moonbeeper/moonpad/macropad/symbols/3dobjs/USB-C-SMD_G-SWITCH_GT-USB-7010ASV.step

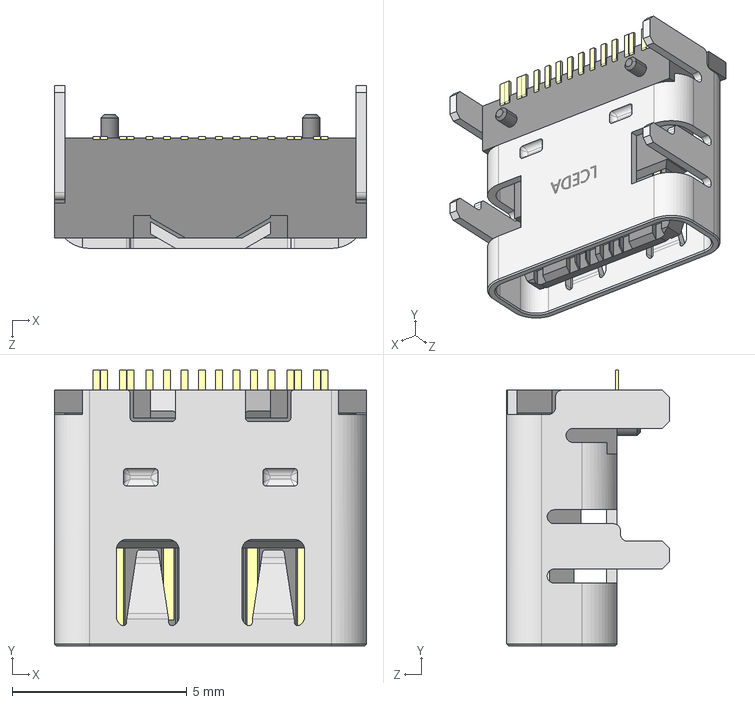
[picture p1: CAD file, 2026-05-30]
macropad/symbols/3dobjs/USB-C-SMD_G-SWITCH_GT-USB-7010ASV.step
8.94 x 7.90 x 4.66 mm
