moonbeeper/moonpad/macropad/symbols/3dobjs/KEY-SMD_2P-L3.0-W2.5-H1.6-LS4.0.step

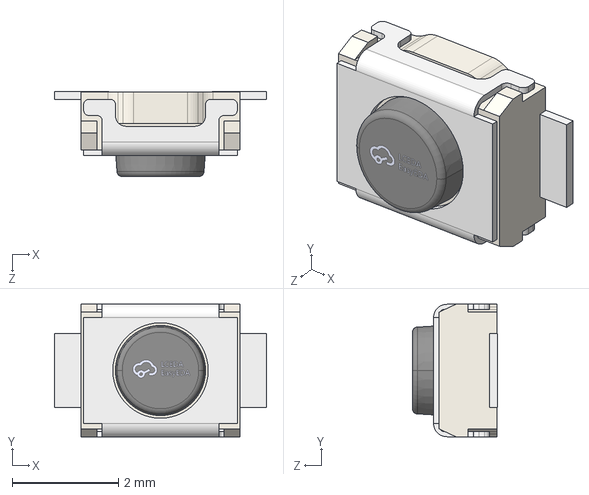
[picture p2: CAD file, 2026-05-30]
macropad/symbols/3dobjs/KEY-SMD_2P-L3.0-W2.5-H1.6-LS4.0.step
4.00 x 2.50 x 1.61 mm
