moonbeeper/moonpad/macropad/symbols/3dobjs/SW-SMD_MK-12C02-G020.step

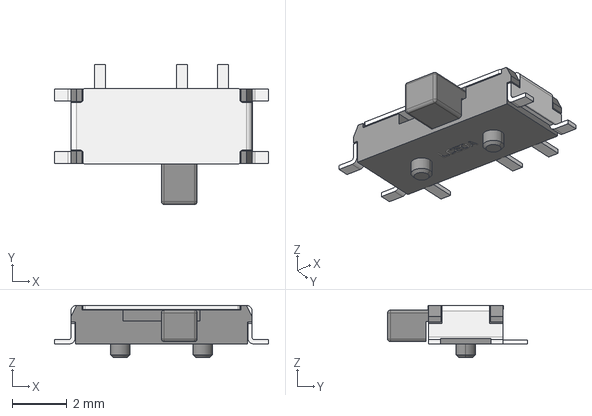
[picture p3: CAD file, 2026-05-30]
macropad/symbols/3dobjs/SW-SMD_MK-12C02-G020.step
7.80 x 5.10 x 1.90 mm
