moonbeeper/moonpad/macropad/symbols/3dobjs/SW-TH_EC11XXXXXXXX-L11.7-W12.0-H24.5-P2.5-LS14.5.step

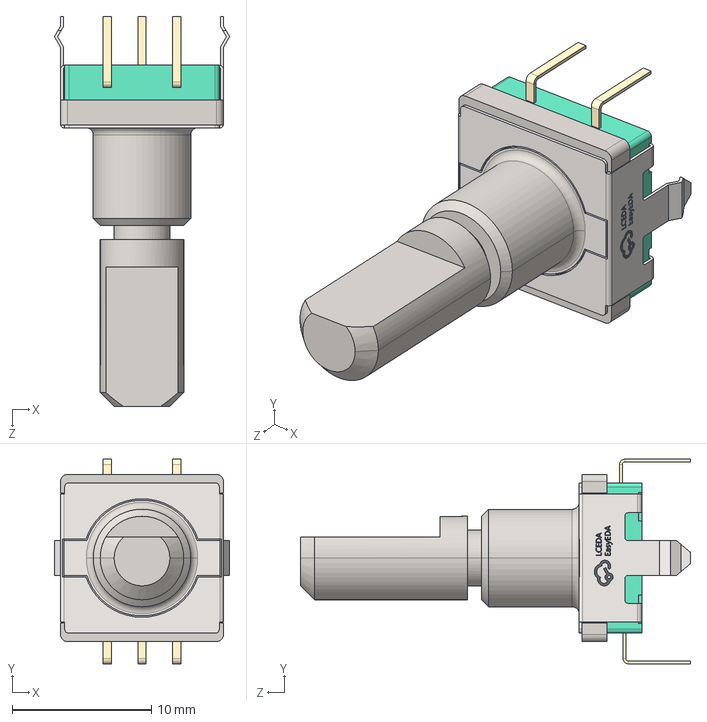
[picture p4: CAD file, 2026-05-30]
macropad/symbols/3dobjs/SW-TH_EC11XXXXXXXX-L11.7-W12.0-H24.5-P2.5-LS14.5.step
12.6 x 14.7 x 28.0 mm
