moonbeeper/moonpad/macropad/symbols/3dobjs/KEY-SMD_L4.6-W3.4-H3.4.step

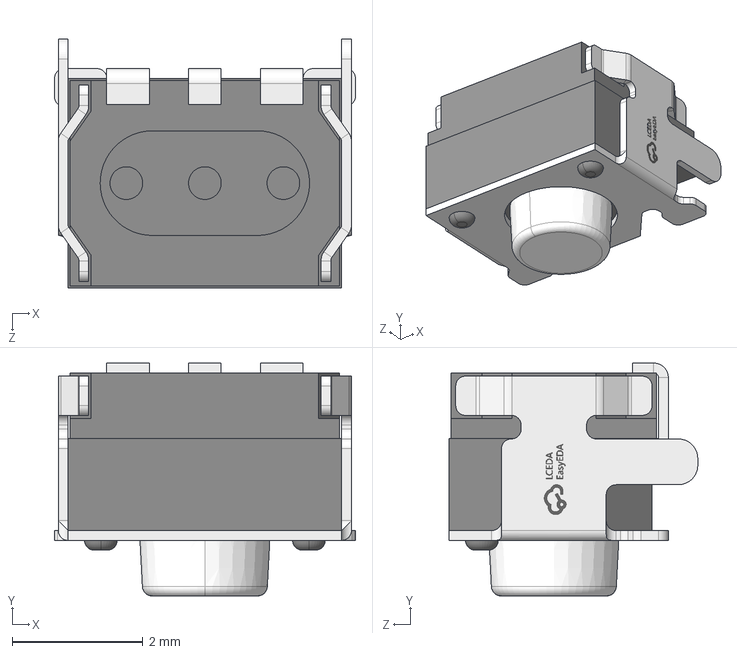
[picture p5: CAD file, 2026-05-30]
macropad/symbols/3dobjs/KEY-SMD_L4.6-W3.4-H3.4.step
4.60 x 3.56 x 3.80 mm
