moonbeeper/moonpad/macropad/macropad.kicad_pcb

## KiCad design macropad/macropad.kicad_pcb (2026-05-30)

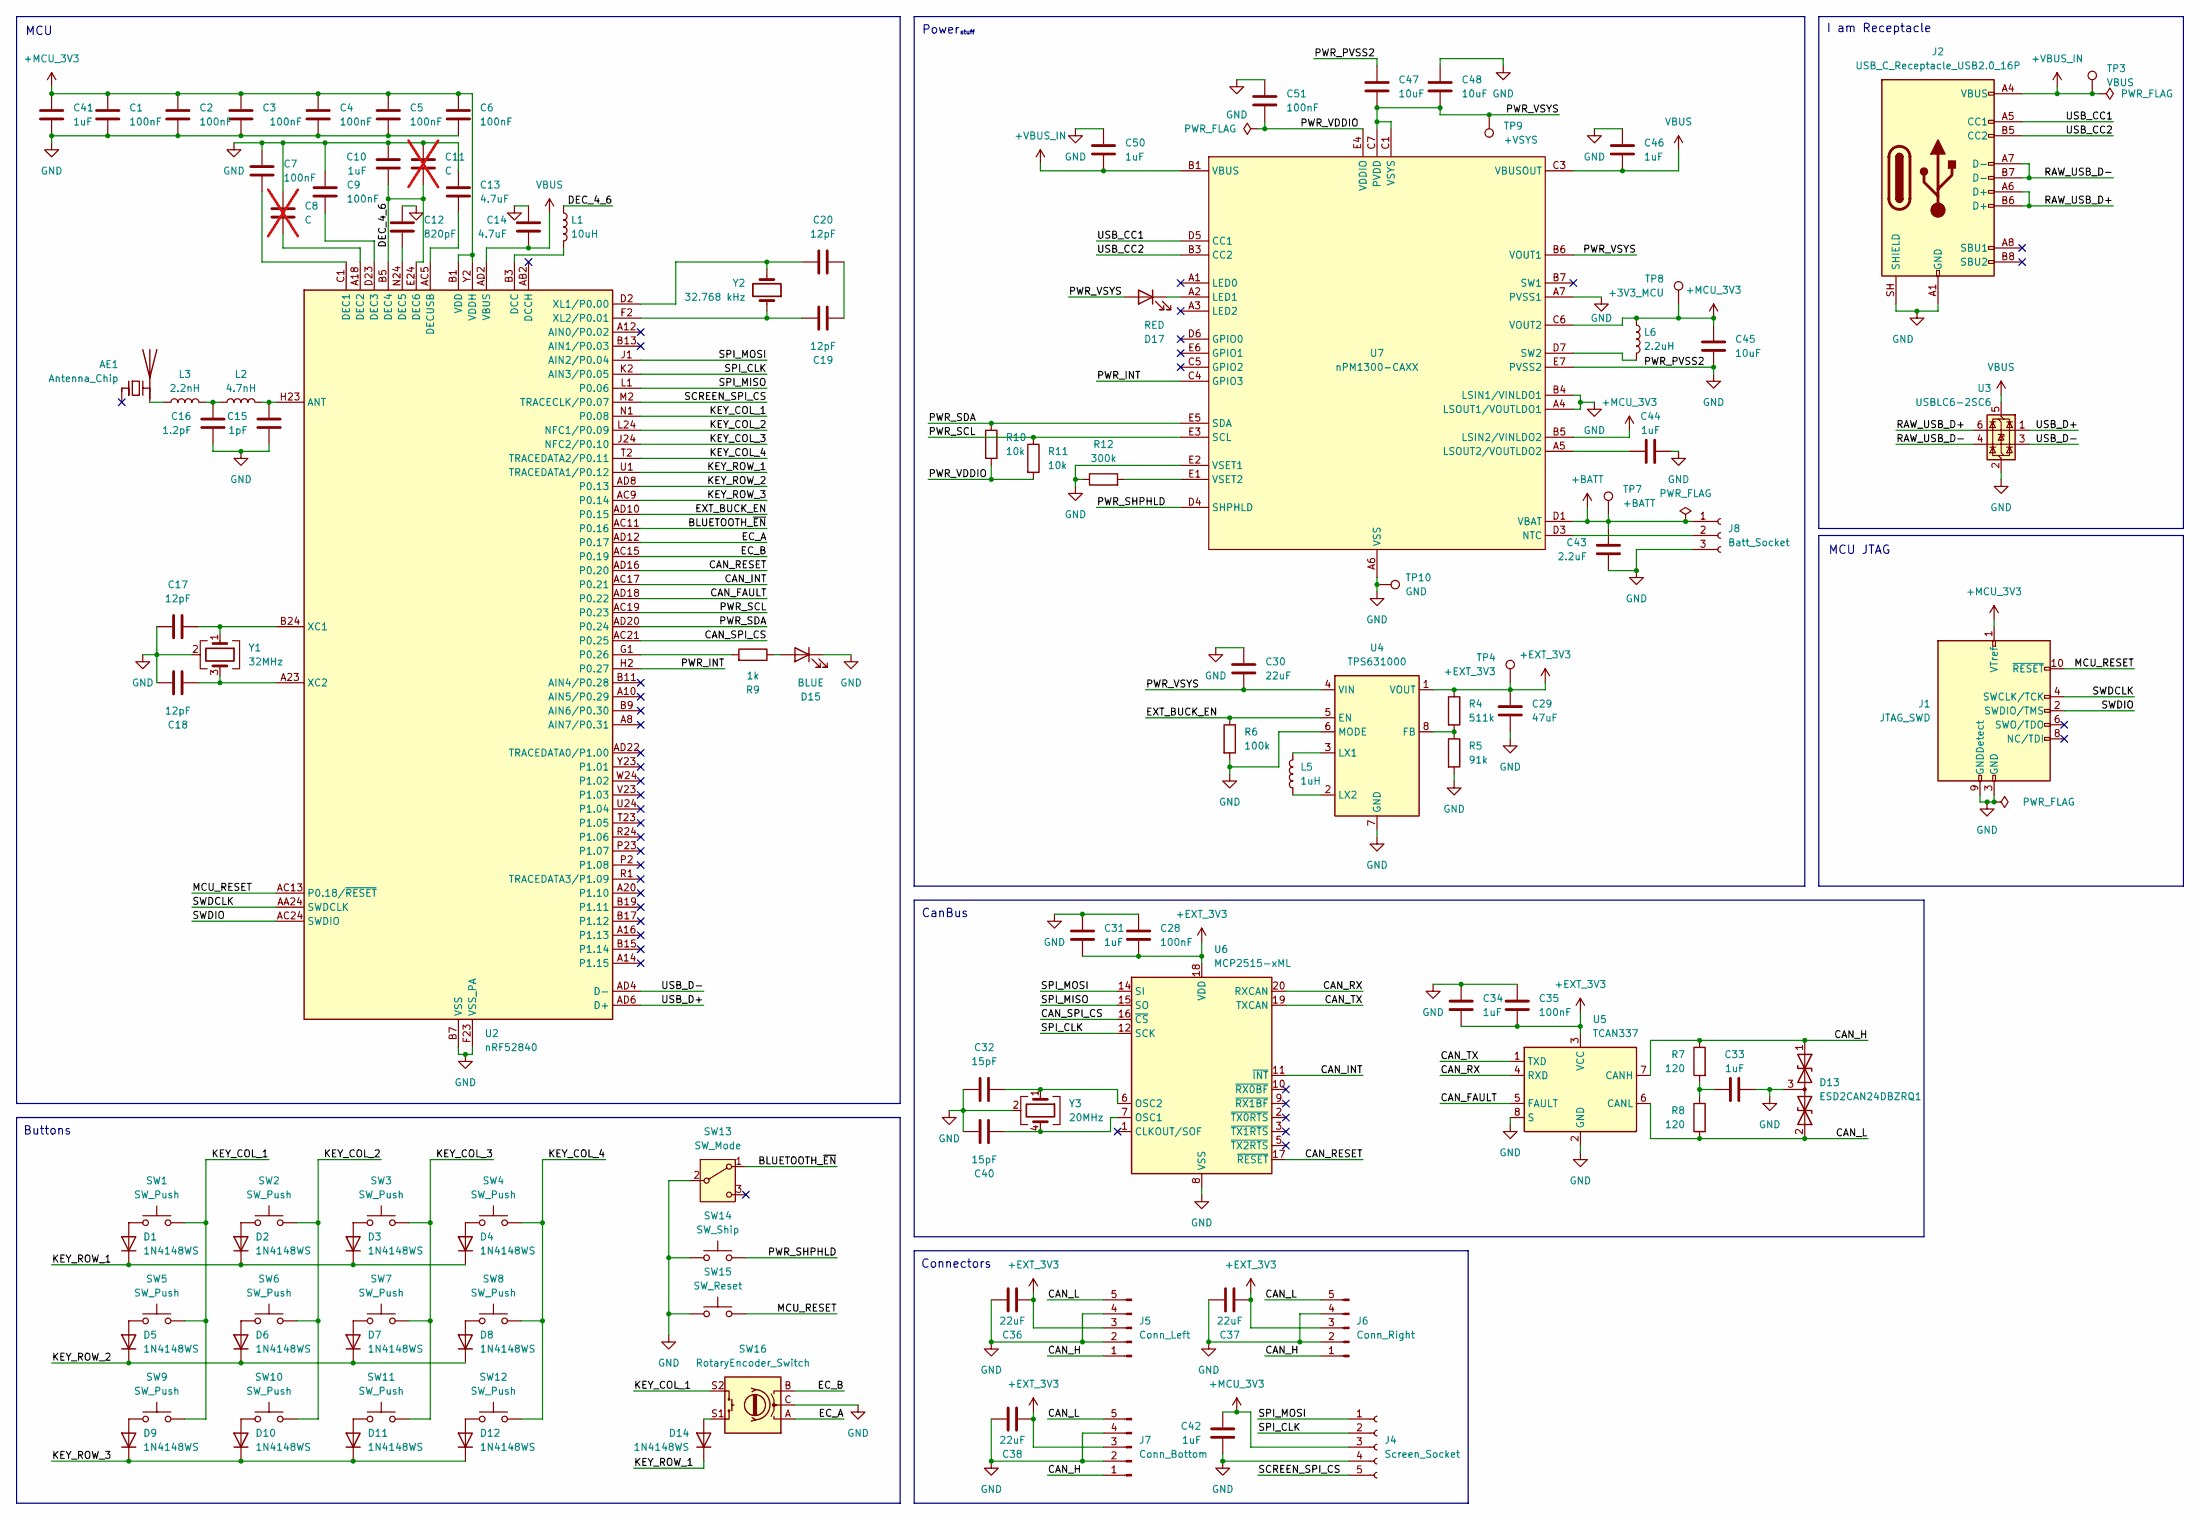
[picture p6: schematic macropad.kicad_sch, MoonPad Macropad]

Parts:
AE1: Antenna_Chip; D_1206_3216Metric; MPN ANT3216LL00R2400A; LCSC C293767
C1, C2, C3, C4, C5, C6, C7, C9, C28, C35, C51: 100nF; C_0603_1608Metric; MPN CC0603KRX7R9BB104; LCSC C14663
C8, C11: C; not fitted
C10, C31, C33, C34, C41, C42, C44, C46, C50: 1uF; C_0603_1608Metric; MPN CL10B105KB8NQNC; LCSC C5199872
C12: 820pF; C_0603_1608Metric; MPN CC0603JRNPO9BN821; LCSC C107057
C13, C14: 4.7uF; C_0603_1608Metric; MPN GRM188Z71C475KE21D; LCSC C389010
C15: 1pF; C_0402_1005Metric; MPN CC0402BRNPO9BN1R0; LCSC C309455
C16: 1.2pF; C_0402_1005Metric; MPN CC0402BRNPO9BN1R2; LCSC C327292
C17, C18, C19, C20: 12pF; C_0603_1608Metric; MPN CC0603GRNPO9BN120; LCSC C519450
C29: 47uF; C_0805_2012Metric; MPN GRM21BR61A476ME15L; LCSC C124129
C30, C36, C37, C38: 22uF; C_0805_2012Metric; MPN CL21A226MPQNNNE; LCSC C29277
C32, C40: 15pF; C_0603_1608Metric; MPN CC0603GRNPO9BN150; LCSC C519451
C43: 2.2uF; C_0603_1608Metric; MPN CL10A225KB8NNNC; LCSC C913904
C45, C47, C48: 10uF; C_0603_1608Metric; MPN GRM188R61E106KA73D; LCSC C344022
D1, D2, D3, D4, D5, D6, D7, D8, D9, D10, D11, D12, D14: 1N4148WS; D_SOD-323; MPN 1N4148WS; LCSC C917117
D13: ESD2CAN24DBZRQ1; SOT-23-3; MPN ESD2CAN24DBZRQ1
D15: BLUE; LED_0603_1608Metric; MPN GL0603UB01; LCSC C51933294
D17: RED; LED_0603_1608Metric; MPN GL0603UR01; LCSC C51933292
J1: JTAG_SWD; PinHeader_2x05_P1.27mm_Vertical
J2: USB_C_Receptacle_USB2.0_16P; USB_C_Receptacle_G-Switch_GT-USB-7010ASV; MPN GT-USB-7010ASV; LCSC C2988369
J4: Screen_Socket; PinHeader_1x05_P2.00mm_Vertical
J5: Conn_Left; PinHeader_1x05_P2.00mm_Vertical
J6: Conn_Right; PinHeader_1x05_P2.00mm_Vertical
J7: Conn_Bottom; PinHeader_1x05_P2.00mm_Vertical
J8: Batt_Socket; PinHeader_1x05_P2.00mm_Vertical
L1: 10uH; L_0603_1608Metric; MPN MLZ1608N100LT000; LCSC C194437
L2: 4.7nH; L_0402_1005Metric; MPN LQG15HS4N7S02D; LCSC C86065
L3: 2.2nH; L_0402_1005Metric; MPN LQG15HS2N2S02D; LCSC C86061
L5: 1uH; L_1008_2520Metric; MPN DFE252012P-1R0M=P2; LCSC C882955
L6: 2.2uH; L_0805_2012Metric; MPN DFE201210U-2R2M=P2; LCSC C2049745
R4: 511k; R_0603_1608Metric; MPN FRC0603F5113TS; LCSC C2930114
R5: 91k; R_0603_1608Metric; MPN FRC0603F9102TS; LCSC C2907077
R6: 100k; R_0603_1608Metric; MPN FRC0603F1003TS; LCSC C2906980
R7, R8: 120; R_0603_1608Metric; MPN FRC0603F1200TS; LCSC C2906988
R9: 1k; R_0603_1608Metric; MPN FRC0603F1001TS; LCSC C2907002
R10, R11: 10k; R_0603_1608Metric; MPN FRC0603J103 TS; LCSC C2930027
R12: 300k; R_0603_1608Metric; MPN FRC0603F3003TS; LCSC C2930091
SW1, SW2, SW3, SW4, SW5, SW6, SW7, SW8, SW9, SW10, SW11, SW12: SW_Push; SW_Hotswap_Kailh_Choc_V1V2_1.00u
SW13: SW_Mode; SW-SMD_MK-12C02-G020; MPN MK-12C02-G020; LCSC C963206
SW14: SW_Ship; KEY-SMD_SKRTLAE010; MPN SKRTLAE010; LCSC C110293
SW15: SW_Reset; KEY-SMD_B3U-1000PM; MPN B3U-1000P; LCSC C231329
SW16: RotaryEncoder_Switch; RotaryEncoder_Alps_EC11E-Switch_Vertical_H20mm; MPN EC11E09244BS; LCSC C470742
TP3: VBUS; TestPoint_Pad_D1.5mm
TP4: +EXT_3V3; TestPoint_Pad_D1.5mm
TP7: +BATT; TestPoint_Pad_D1.5mm
TP8: +3V3_MCU; TestPoint_Pad_D1.5mm
TP9: +VSYS; TestPoint_Pad_D1.5mm
TP10: GND; TestPoint_Pad_D1.5mm
U2: nRF52840; Nordic_AQFN-73-1EP_7x7mm_P0.5mm; MPN NRF52840-QIAA-F-R7
U3: USBLC6-2SC6; SOT-23-6; MPN USBLC6-2SC6; LCSC C2827654
U4: TPS631000; SOT-583-8; MPN TPS631000DRLR; LCSC C5219190
U5: TCAN337; SOIC-8_3.9x4.9mm_P1.27mm; MPN TCAN337DR; LCSC C2860648
U6: MCP2515-xML; QFN-20-1EP_4x4mm_P0.5mm_EP2.7x2.7mm; MPN MCP2515T-I/ML; LCSC C96140
U7: nPM1300-CAXX; BGA-35_7x5_3.077x2.3775mm; MPN NPM1300-CAAA-R
Y1: 32MHz; Crystal_SMD_2016-4Pin_2.0x1.6mm; MPN TX201632M4BBCE2T; LCSC C5339095
Y2: 32.768 kHz; Crystal_SMD_2012-2Pin_2.0x1.2mm; MPN SC-20S,32.768kHz,20PPM,9pF; LCSC C97603
Y3: 20MHz; Crystal_SMD_3225-4Pin_3.2x2.5mm; MPN 2.1.3.1600011; LCSC C42420972

Connections:
+BATT: C43.1, J8.1, TP7.1 (1_1), U7.D1 (VBAT), U7.D2 (VBAT)
+EXT_3V3: C28.2, C29.1, C31.2, C34.2, C35.2, C36.1, C37.1, C38.1, J5.3, J6.3, J7.3, R4.1, TP4.1 (1_1), U4.1 (VOUT), U5.3 (VCC), U6.18 (VDD)
+MCU_3V3: C1.1, C2.1, C3.1, C4.1, C5.1, C6.1, C41.1, C42.1, C45.1, J1.1 (VTref), J4.3, L6.1, TP8.1 (1_1), U2.A22 (VDD), U2.AD14 (VDD), U2.AD23 (VDD), U2.B1 (VDD), U2.W1 (VDD), U2.Y2 (VDDH), U7.B5 (LSIN2/VINLDO2), U7.C6 (VOUT2)
+VBUS_IN: C50.2, J2.A4 (VBUS), J2.A9 (VBUS), J2.B4 (VBUS), J2.B9 (VBUS), TP3.1 (1_1), U7.B1 (VBUS), U7.B2 (VBUS)
/BLUETOOTH_~EN: SW13.1 (A), U2.AC11 (P0.16)
/CAN_FAULT: U2.AD18 (P0.22), U5.5 (FAULT)
/CAN_H: D13.1 (A1), J5.1, J6.1, J7.1, R7.1, U5.7 (CANH)
/CAN_INT: U2.AC17 (P0.21), U6.11 (~INT)
/CAN_L: D13.2 (A2), J5.5, J6.5, J7.5, R8.2, U5.6 (CANL)
/CAN_RESET: U2.AD16 (P0.20), U6.17 (~RESET)
/CAN_RX: U5.4 (RXD), U6.20 (RXCAN)
/CAN_SPI_CS: U2.AC21 (P0.25), U6.16 (~CS)
/CAN_TX: U5.1 (TXD), U6.19 (TXCAN)
/DEC_4_6: C10.2, C11.2, L1.1, U2.B5 (DEC4), U2.E24 (DEC6)
/EC_A: SW16.A, U2.AD12 (P0.17)
/EC_B: SW16.B, U2.AC15 (P0.19)
/EXT_BUCK_EN: R6.1, U2.AD10 (P0.15), U4.5 (EN)
/KEY_COL_1: SW1.2, SW5.2, SW9.2, SW16.S2, U2.N1 (P0.08)
/KEY_COL_2: SW2.2, SW6.2, SW10.2, U2.L24 (NFC1/P0.09)
/KEY_COL_3: SW3.2, SW7.2, SW11.2, U2.J24 (NFC2/P0.10)
/KEY_COL_4: SW4.2, SW8.2, SW12.2, U2.T2 (TRACEDATA2/P0.11)
/KEY_ROW_1: D1.1 (K), D2.1 (K), D3.1 (K), D4.1 (K), D14.1 (K), U2.U1 (TRACEDATA1/P0.12)
/KEY_ROW_2: D5.1 (K), D6.1 (K), D7.1 (K), D8.1 (K), U2.AD8 (P0.13)
/KEY_ROW_3: D9.1 (K), D10.1 (K), D11.1 (K), D12.1 (K), U2.AC9 (P0.14)
/MCU_RESET: J1.10 (~RESET), SW15.2, U2.AC13 (P0.18/~RESET)
/PWR_INT: U2.H2 (P0.27), U7.C4 (GPIO3)
/PWR_SCL: R11.1, U2.AC19 (P0.23), U7.E3 (SCL)
/PWR_SDA: R10.1, U2.AD20 (P0.24), U7.E5 (SDA)
/PWR_SHPHLD: SW14.2, U7.D4 (SHPHLD)
/PWR_VDDIO: C51.2, R10.2, R11.2, U7.E4 (VDDIO)
/PWR_VSYS: C30.2, C47.2, C48.2, D17.2 (A), TP9.1 (1_1), U4.4 (VIN), U7.B6 (VOUT1), U7.C1 (VSYS), U7.C2 (VSYS), U7.C7 (PVDD)
/RAW_USB_D+: J2.A6 (D+), J2.B6 (D+), U3.6 (I/O1)
/RAW_USB_D-: J2.A7 (D-), J2.B7 (D-), U3.4 (I/O2)
/SCREEN_SPI_CS: J4.5, U2.M2 (TRACECLK/P0.07)
/SPI_CLK: J4.2, U2.K2 (AIN3/P0.05), U6.12 (SCK)
/SPI_MISO: U2.L1 (P0.06), U6.15 (SO)
/SPI_MOSI: J4.1, U2.J1 (AIN2/P0.04), U6.14 (SI)
/SWDCLK: J1.4 (SWCLK/TCK), U2.AA24 (SWDCLK)
/SWDIO: J1.2 (SWDIO/TMS), U2.AC24 (SWDIO)
/USB_CC1: J2.A5 (CC1), U7.D5 (CC1)
/USB_CC2: J2.B5 (CC2), U7.B3 (CC2)
/USB_D+: U2.AD6 (D+), U3.1 (I/O1)
/USB_D-: U2.AD4 (D-), U3.3 (I/O2)
GND: C1.2, C2.2, C3.2, C4.2, C5.2, C6.2, C7.1, C8.1, C9.1, C10.1, C11.1, C12.1, C13.1, C14.1, C15.2, C16.2, C17.2, C18.2, C28.1, C29.2, C30.1, C31.1, C32.1, C33.2, C34.1, C35.1, C36.2, C37.2, C38.2, C40.1, C41.2, C42.2, C43.2, C44.2, C45.2, C46.1, C47.1, C48.1, C50.1, C51.1, D13.3 (common), D15.1 (K), J1.3 (GND), J1.5 (GND), J1.9 (GNDDetect), J2.A1 (GND), J2.A12 (GND), J2.B1 (GND), J2.B12 (GND), J2.SH (SHIELD), J4.4, J5.2, J5.4, J6.2, J6.4, J7.2, J7.4, J8.3, R5.2, R6.2, R12.1, SW13.2 (B), SW14.1, SW15.1, SW16.C, TP10.1 (1_1), U2.B7 (VSS), U2.EP (VSS), U2.F23 (VSS_PA), U3.2 (GND), U4.6 (MODE), U4.7 (GND), U5.2 (GND), U5.8 (S), U6.8 (VSS), U6.21 (EP), U7.A4 (LSOUT1/VOUTLDO1), U7.A6 (VSS), U7.A7 (PVSS1), U7.B4 (LSIN1/VINLDO1), U7.E2 (VSET1), U7.E7 (PVSS2), Y1.2 (G), Y1.4 (G), Y3.2 (G), Y3.3 (G)
unnamed: AE1.2 (PCB_Trace_2), L3.1
unnamed: C16.1, L2.1, L3.2
unnamed: C19.2, C20.2
unnamed: C33.1, R7.2, R8.1
unnamed: D1.2 (A), SW1.1
unnamed: D2.2 (A), SW2.1
unnamed: D3.2 (A), SW3.1
unnamed: D4.2 (A), SW4.1
unnamed: D5.2 (A), SW5.1
unnamed: D6.2 (A), SW6.1
unnamed: D7.2 (A), SW7.1
unnamed: D8.2 (A), SW8.1
unnamed: D9.2 (A), SW9.1
unnamed: D10.2 (A), SW10.1
unnamed: D11.2 (A), SW11.1
unnamed: D12.2 (A), SW12.1
unnamed: D14.2 (A), SW16.S1
unnamed: D15.2 (A), R9.1
unnamed: D17.1 (K), U7.A2 (LED1)
unnamed: J8.2, U7.D3 (NTC)
unnamed: C15.1, L2.2, U2.H23 (ANT)
unnamed: L1.2, U2.B3 (DCC)
unnamed: C7.2, U2.C1 (DEC1)
unnamed: C8.2, U2.A18 (DEC2)
unnamed: C9.2, U2.D23 (DEC3)
unnamed: C12.2, U2.N24 (DEC5)
unnamed: C13.2, U2.AC5 (DECUSB)
unnamed: R9.2, U2.G1 (P0.26)
unnamed: C17.1, U2.B24 (XC1), Y1.1
unnamed: C18.1, U2.A23 (XC2), Y1.3
unnamed: C20.1, U2.D2 (XL1/P0.00), Y2.2
unnamed: C19.1, U2.F2 (XL2/P0.01), Y2.1
unnamed: R4.2, R5.1, U4.8 (FB)
unnamed: L5.2, U4.3 (LX1)
unnamed: L5.1, U4.2 (LX2)
unnamed: C40.2, U6.7 (OSC1), Y3.4
unnamed: C32.2, U6.6 (OSC2), Y3.1
unnamed: C44.1, U7.A5 (LSOUT2/VOUTLDO2)
unnamed: L6.2, U7.D7 (SW2)
unnamed: R12.2, U7.E1 (VSET2)
VBUS: C14.2, C46.2, U2.AD2 (VBUS), U3.5 (VBUS), U7.C3 (VBUSOUT)

Notes on the sheet:
Power
MCU
Buttons
stuff
I am Receptacle
CanBus
Connectors
MCU JTAG

Board: 2 copper layers, 109 parts (0 on the bottom side), 84 nets, no tracks yet.
