moonbeeper/moonpad/(commit log)

2026-05-18 baby steps of macropad schematic
2026-05-20 forgot kicad project :)
    [macropad.kicad_pcb, macropad.kicad_sch]
2026-05-23 finished macropad schematic
    [macropad.kicad_sch]
2026-05-24 schematic cleanup
    [macropad.kicad_sch]
2026-05-30 journal+pcb: lcsc ids, mpns, 3d models of components
    [KEY-SMD_2P-L3.0-W2.5-H1.6-LS4.0.step, KEY-SMD_L4.6-W3.4-H3.4.step, SW-SMD_MK-12C02-G020.step, SW-TH_EC11XXXXXXXX-L11.7-W12.0-H24.5-P2.5-LS14.5.step, USB-C-SMD_G-SWITCH_GT-USB-7010ASV.step, macropad.kicad_pcb, macropad.kicad_sch]
